OxfordIonTrapGroup/CurrentStabilizer/software/readme.txt

This project was built with:
MPLAB X IDE v3.10
MPLAB XC32 Compiler v1.40 (free version)
PIC32 Legacy Peripheral Libraries (8/6/2015 or 17/6/2015)
