OxfordIonTrapGroup/CurrentStabilizer/current stabiliser.brd

## EAGLE design current stabiliser.brd (2019-03-14)

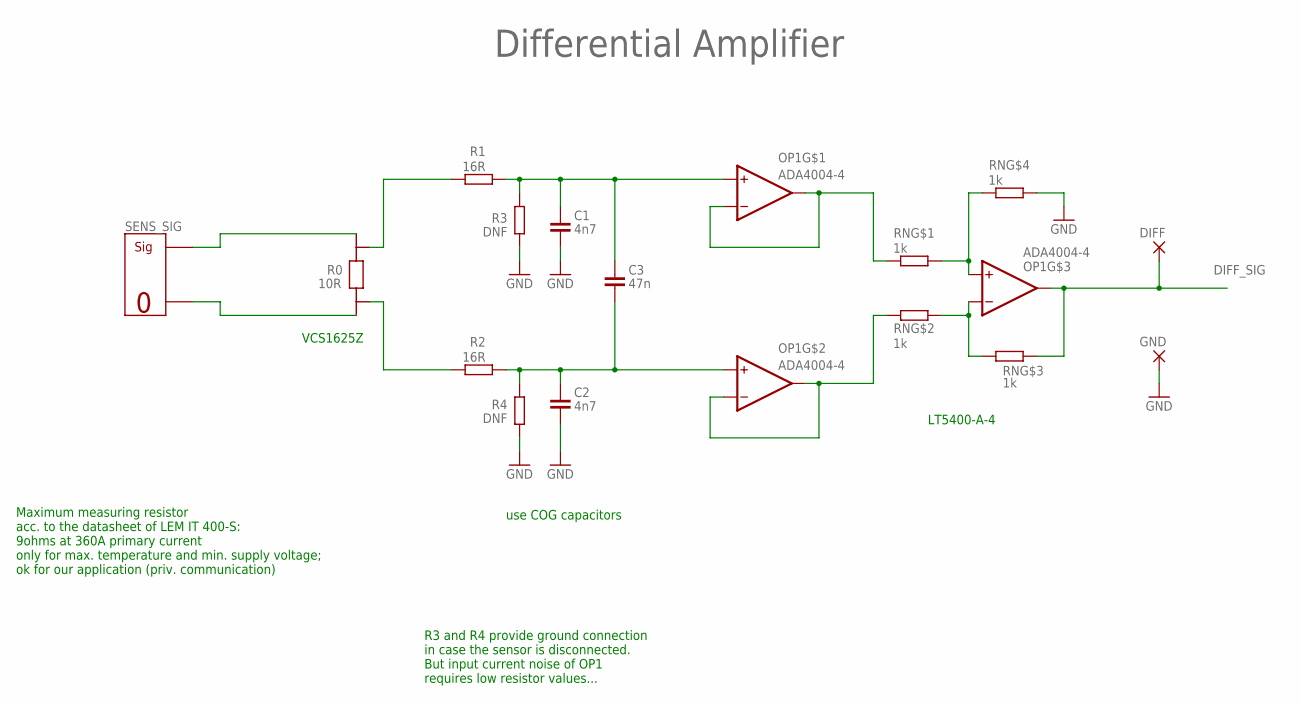
[picture p1: schematic current stabiliser.sch, sheet 1]

Parts:
C1, C2: 4n7; 0603
C3: 47n; 0603
DIFF: TESTPOINT
GND: TESTPOINT
OP1: ADA4004-4; SO14
R0: 10R; VCS1625Z
R1, R2: 16R; 0603
R3, R4: DNF; 0603
RN: 1k; MSOP8-EP
SENS_SIG: MOLEX_SIG_2PIN; MOLEX-2PIN

Connections:
DIFF_SIG: DIFF.P$1, OP1.P$8 (OUT), RN.3 (1); also elsewhere on the board
GND: C1.2, C2.2, GND.P$1, R3.1, R4.1, RN.5 (2); also elsewhere on the board
unnamed: R0.P$1 (I1), SENS_SIG.2 (SIG)
unnamed: C2.1, C3.2, OP1.P$5 (+IN), R2.2, R4.2
unnamed: R0.P$4 (E2), R2.1
unnamed: R0.P$3 (E1), R1.1
unnamed: C1.1, C3.1, OP1.P$3 (+IN), R1.2, R3.2
unnamed: OP1.P$1 (OUT), OP1.P$2 (-IN), RN.1
unnamed: OP1.P$6 (-IN), OP1.P$7 (OUT), RN.2 (1)
unnamed: OP1.P$10 (+IN), RN.4 (1), RN.8 (2)
unnamed: OP1.P$9 (-IN), RN.6 (2), RN.7 (2)
SENS_RETURN: R0.P$2 (I2), SENS_SIG.1 (GND)

Notes on the sheet:
Differential Amplifier
use COG capacitors
R3 and R4 provide ground connection in case the sensor is disconnected. But input current noise of OP1 requires low resistor values...
Maximum measuring resistor acc. to the datasheet of LEM IT 400-S: 9ohms at 360A primary current only for max. temperature and min. supply voltage; ok for our application (priv. communication)
VCS1625Z
LT5400-A-4

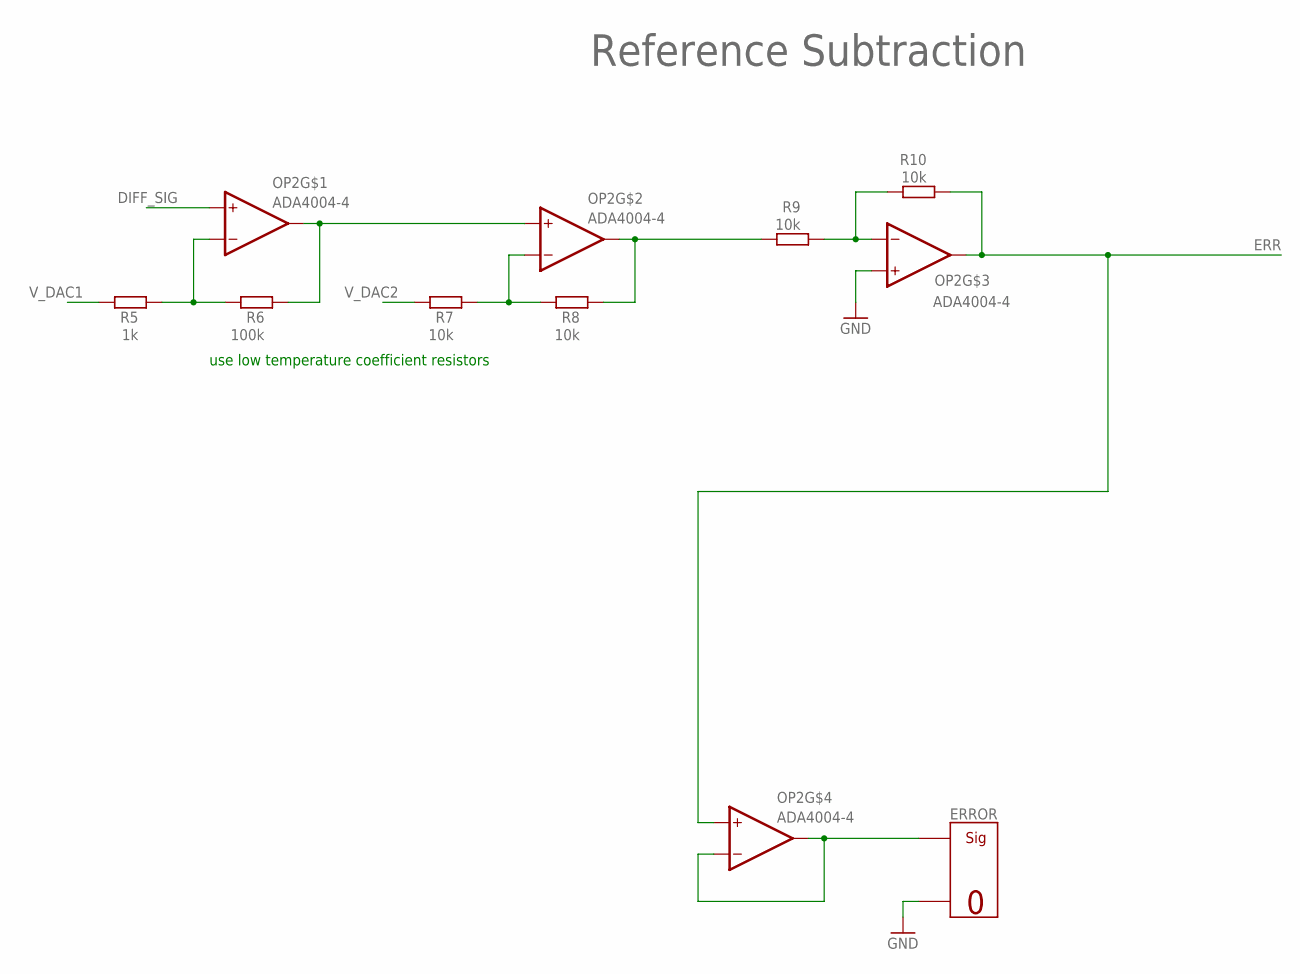
[picture p2: schematic current stabiliser.sch, sheet 2]

Parts:
ERROR: MOLEX_SIG_2PIN; MOLEX-2PIN
OP2: ADA4004-4; SO14
R5: 1k; 0603
R6: 100k; 0603
R7, R8, R9, R10: 10k; 0603

Connections:
DIFF_SIG: OP2.P$3 (+IN); also elsewhere on the board
ERR: OP2.P$8 (OUT), OP2.P$12 (+IN), R10.2; also elsewhere on the board
GND: ERROR.1 (GND), OP2.P$10 (+IN); also elsewhere on the board
unnamed: OP2.P$2 (-IN), R5.2, R6.1
unnamed: OP2.P$9 (-IN), R9.2, R10.1
unnamed: OP2.P$1 (OUT), OP2.P$5 (+IN), R6.2
unnamed: OP2.P$6 (-IN), R7.2, R8.1
unnamed: OP2.P$7 (OUT), R8.2, R9.1
unnamed: ERROR.2 (SIG), OP2.P$13 (-IN), OP2.P$14 (OUT)
V_DAC1: R5.1; also elsewhere on the board
V_DAC2: R7.1; also elsewhere on the board

Notes on the sheet:
Reference Subtraction
use low temperature coefficient resistors

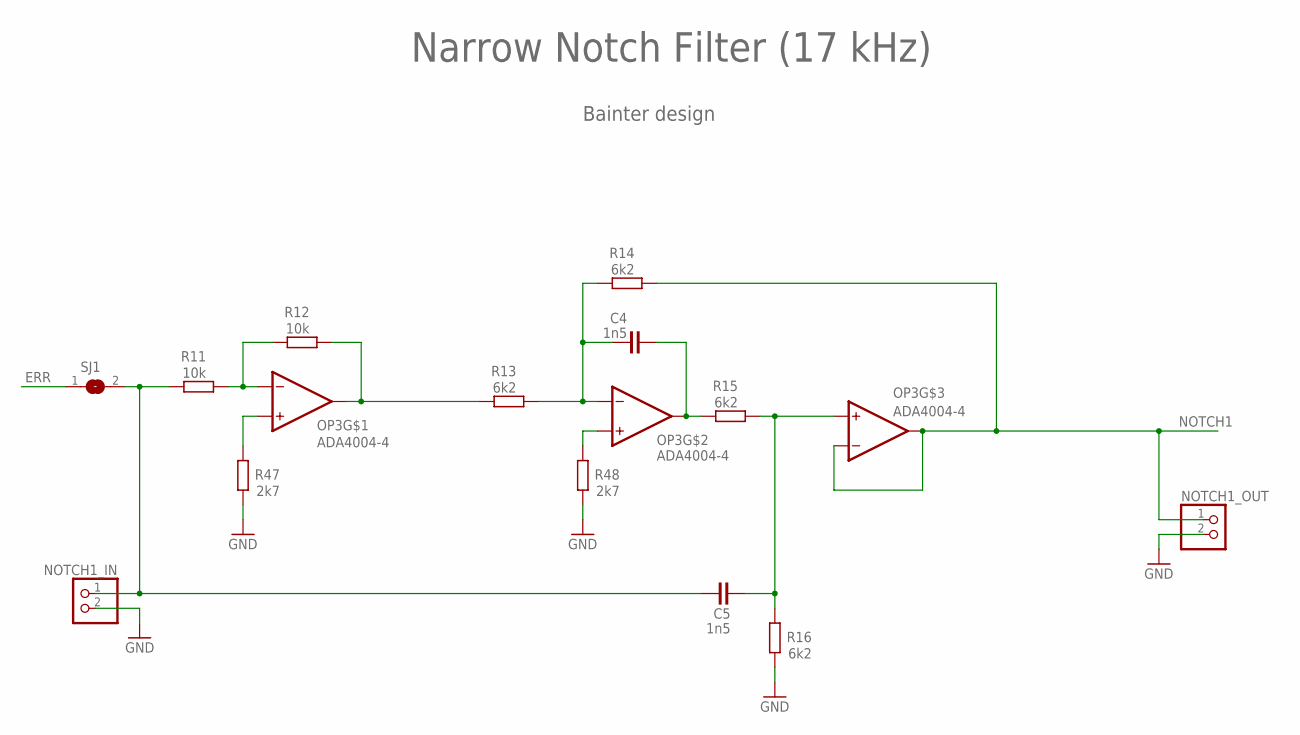
[picture p3: schematic current stabiliser.sch, sheet 3]

Parts:
C4, C5: 1n5; 0603
NOTCH1_IN, NOTCH1_OUT: PINHD-1X2; 1X02
OP3: ADA4004-4; SO14
R11, R12: 10k; 0603
R13, R14, R15, R16: 6k2; 0603
R47, R48: 2k7; 0603
SJ1: SJ

Connections:
ERR: SJ1.1; also elsewhere on the board
GND: NOTCH1_IN.2, NOTCH1_OUT.2, R16.2, R47.2, R48.2; also elsewhere on the board
unnamed: OP3.P$2 (-IN), R11.2, R12.1
unnamed: OP3.P$1 (OUT), R12.2, R13.1
unnamed: C4.1, OP3.P$6 (-IN), R13.2, R14.1
unnamed: C4.2, OP3.P$7 (OUT), R15.1
unnamed: C5.2, OP3.P$10 (+IN), R15.2, R16.1
unnamed: C5.1, NOTCH1_IN.1, R11.1, SJ1.2
unnamed: OP3.P$3 (+IN), R47.1
unnamed: OP3.P$5 (+IN), R48.1
NOTCH1: NOTCH1_OUT.1, OP3.P$8 (OUT), OP3.P$9 (-IN), R14.2; also elsewhere on the board

Notes on the sheet:
Narrow Notch Filter (17 kHz)
Bainter design

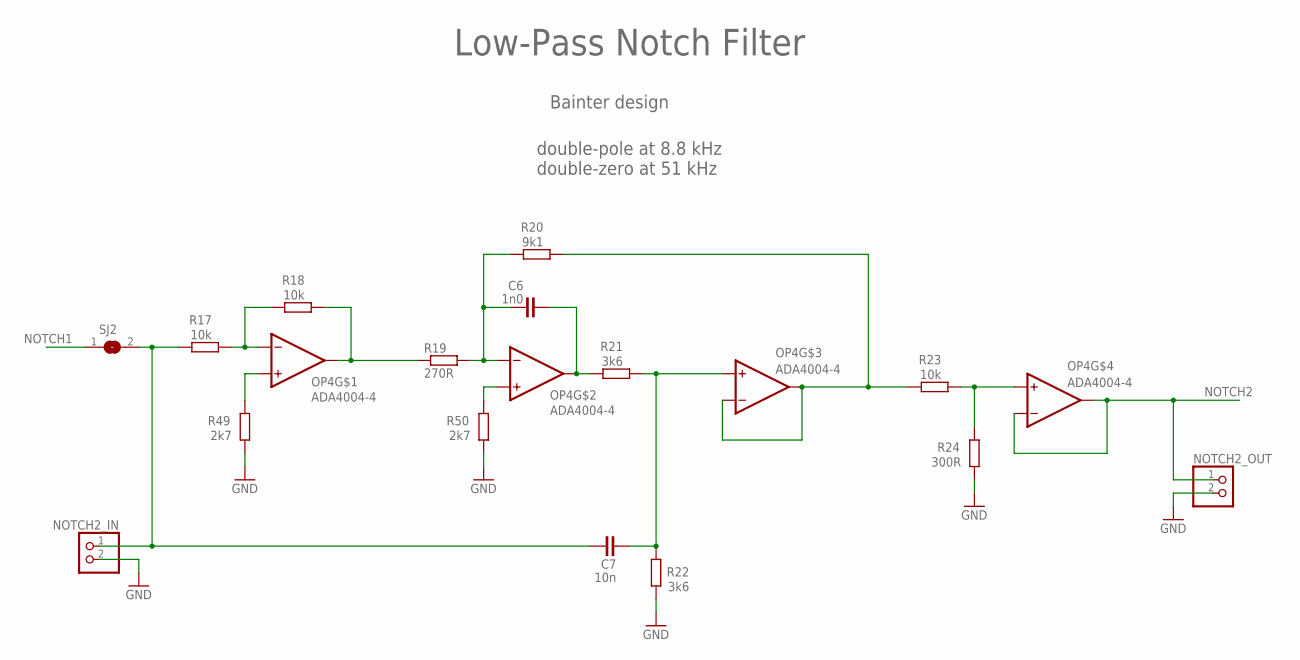
[picture p4: schematic current stabiliser.sch, sheet 4]

Parts:
C6: 1n0; 0603
C7: 10n; 0603
NOTCH2_IN, NOTCH2_OUT: PINHD-1X2; 1X02
OP4: ADA4004-4; SO14
R17, R18, R23: 10k; 0603
R19: 270R; 0603
R20: 9k1; 0603
R21, R22: 3k6; 0603
R24: 300R; 0603
R49, R50: 2k7; 0603
SJ2: SJ

Connections:
GND: NOTCH2_IN.2, NOTCH2_OUT.2, R22.1, R24.1, R49.1, R50.1; also elsewhere on the board
unnamed: OP4.P$2 (-IN), R17.2, R18.1
unnamed: OP4.P$1 (OUT), R18.2, R19.1
unnamed: C6.1, OP4.P$6 (-IN), R19.2, R20.1
unnamed: C7.2, OP4.P$10 (+IN), R21.2, R22.2
unnamed: C6.2, OP4.P$7 (OUT), R21.1
unnamed: OP4.P$8 (OUT), OP4.P$9 (-IN), R20.2, R23.1
unnamed: OP4.P$12 (+IN), R23.2, R24.2
unnamed: C7.1, NOTCH2_IN.1, R17.1, SJ2.2
unnamed: OP4.P$3 (+IN), R49.2
unnamed: OP4.P$5 (+IN), R50.2
NOTCH1: SJ2.1; also elsewhere on the board
NOTCH2: NOTCH2_OUT.1, OP4.P$13 (-IN), OP4.P$14 (OUT); also elsewhere on the board

Notes on the sheet:
Low-Pass Notch Filter
double-pole at 8.8 kHz double-zero at 51 kHz
Bainter design

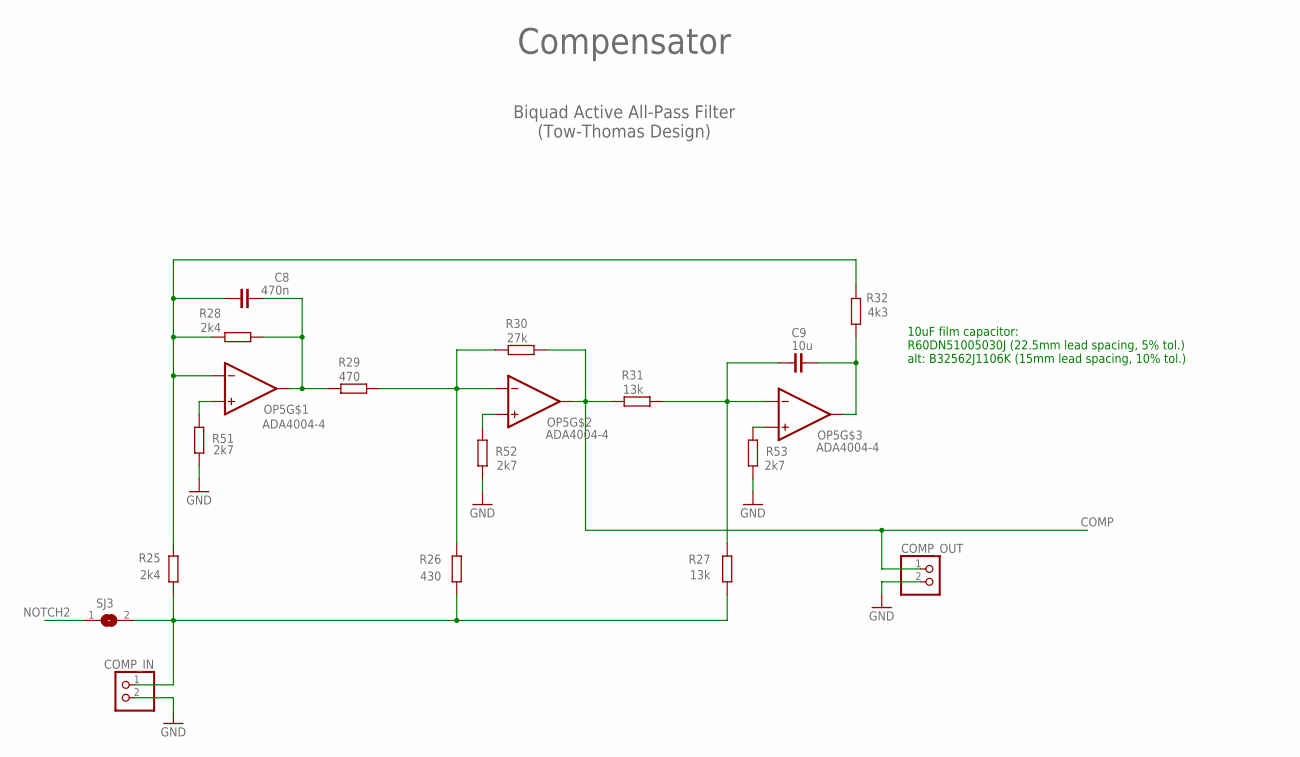
[picture p5: schematic current stabiliser.sch, sheet 5]

Parts:
C8: 470n; 0603
C9: 10u; CAP-26.5X8.5
COMP_IN: PINHD-1X2; 1X02
COMP_OUT: PINHD-1X2; 1X02
OP5: ADA4004-4; SO14
R25, R28: 2k4; 0603
R26: 430; 0603
R27, R31: 13k; 0603
R29: 470; 0603
R30: 27k; 0603
R32: 4k3; 0603
R51, R52, R53: 2k7; 0603
SJ3: SJ

Connections:
COMP: COMP_OUT.1, OP5.P$7 (OUT), R30.2, R31.1; also elsewhere on the board
GND: COMP_IN.2, COMP_OUT.2, R51.1, R52.1, R53.1; also elsewhere on the board
unnamed: C8.1, OP5.P$2 (-IN), R25.2, R28.1, R32.2
unnamed: OP5.P$6 (-IN), R26.2, R29.2, R30.1
unnamed: C9.P$1 (1), OP5.P$9 (-IN), R27.2, R31.2
unnamed: C8.2, OP5.P$1 (OUT), R28.2, R29.1
unnamed: C9.P$2 (2), OP5.P$8 (OUT), R32.1
unnamed: COMP_IN.1, R25.1, R26.1, R27.1, SJ3.2
unnamed: OP5.P$3 (+IN), R51.2
unnamed: OP5.P$5 (+IN), R52.2
unnamed: OP5.P$10 (+IN), R53.2
NOTCH2: SJ3.1; also elsewhere on the board

Notes on the sheet:
10uF film capacitor: R60DN51005030J (22.5mm lead spacing, 5% tol.) alt: B32562J1106K (15mm lead spacing, 10% tol.)
Compensator
Biquad Active All-Pass Filter (Tow-Thomas Design)

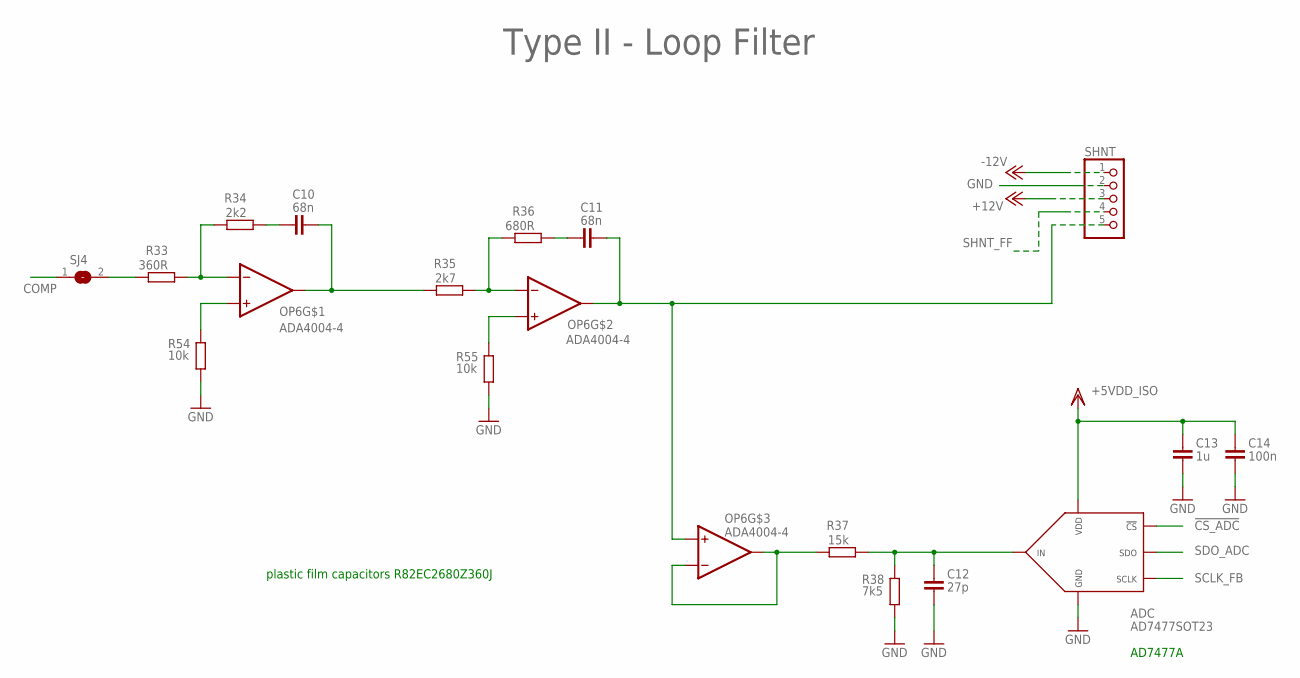
[picture p6: schematic current stabiliser.sch, sheet 6]

Parts:
ADC: AD7477SOT23; SOT23-6
C10, C11: 68n; CAP-R82EC-7.2X2.5
C12: 27p; 0603
C13: 1u; 0805
C14: 100n; 0603
OP6: ADA4004-4; SO14
R33: 360R; 0603
R34: 2k2; 0603
R35: 2k7; 0603
R36: 680R; 0603
R37: 15k; 0603
R38: 7k5; 0603
R54, R55: 10k; 0603
SHNT: MOLEX-KK-1X5; MOLEX-KK-5PIN
SJ4: SJ

Connections:
!CS_ADC: ADC.6 (!CS); also elsewhere on the board
+5VDD_ISO: ADC.1 (VDD), C13.1, C14.1; also elsewhere on the board
+12V: SHNT.3; also elsewhere on the board
-12V: SHNT.1; also elsewhere on the board
COMP: SJ4.1; also elsewhere on the board
GND: ADC.2 (GND), C12.2, C13.2, C14.2, R38.1, R54.1, R55.1, SHNT.2; also elsewhere on the board
unnamed: OP6.P$2 (-IN), R33.2, R34.1
unnamed: OP6.P$3 (+IN), R54.2
unnamed: OP6.P$5 (+IN), R55.2
unnamed: OP6.P$6 (-IN), R35.2, R36.1
unnamed: C11.P$1 (1), R36.2
unnamed: C10.P$1 (1), R34.2
unnamed: C10.P$2 (2), OP6.P$1 (OUT), R35.1
unnamed: OP6.P$8 (OUT), OP6.P$9 (-IN), R37.2
unnamed: ADC.3 (IN), C12.1, R37.1, R38.2
unnamed: R33.1, SJ4.2
SCLK_FB: ADC.4 (SCLK); also elsewhere on the board
SDO_ADC: ADC.5 (SDO); also elsewhere on the board
SHNT_FB: C11.P$2 (2), OP6.P$7 (OUT), OP6.P$10 (+IN), SHNT.5
SHNT_FF: SHNT.4; also elsewhere on the board

Notes on the sheet:
plastic film capacitors R82EC2680Z360J
Type II - Loop Filter
AD7477A

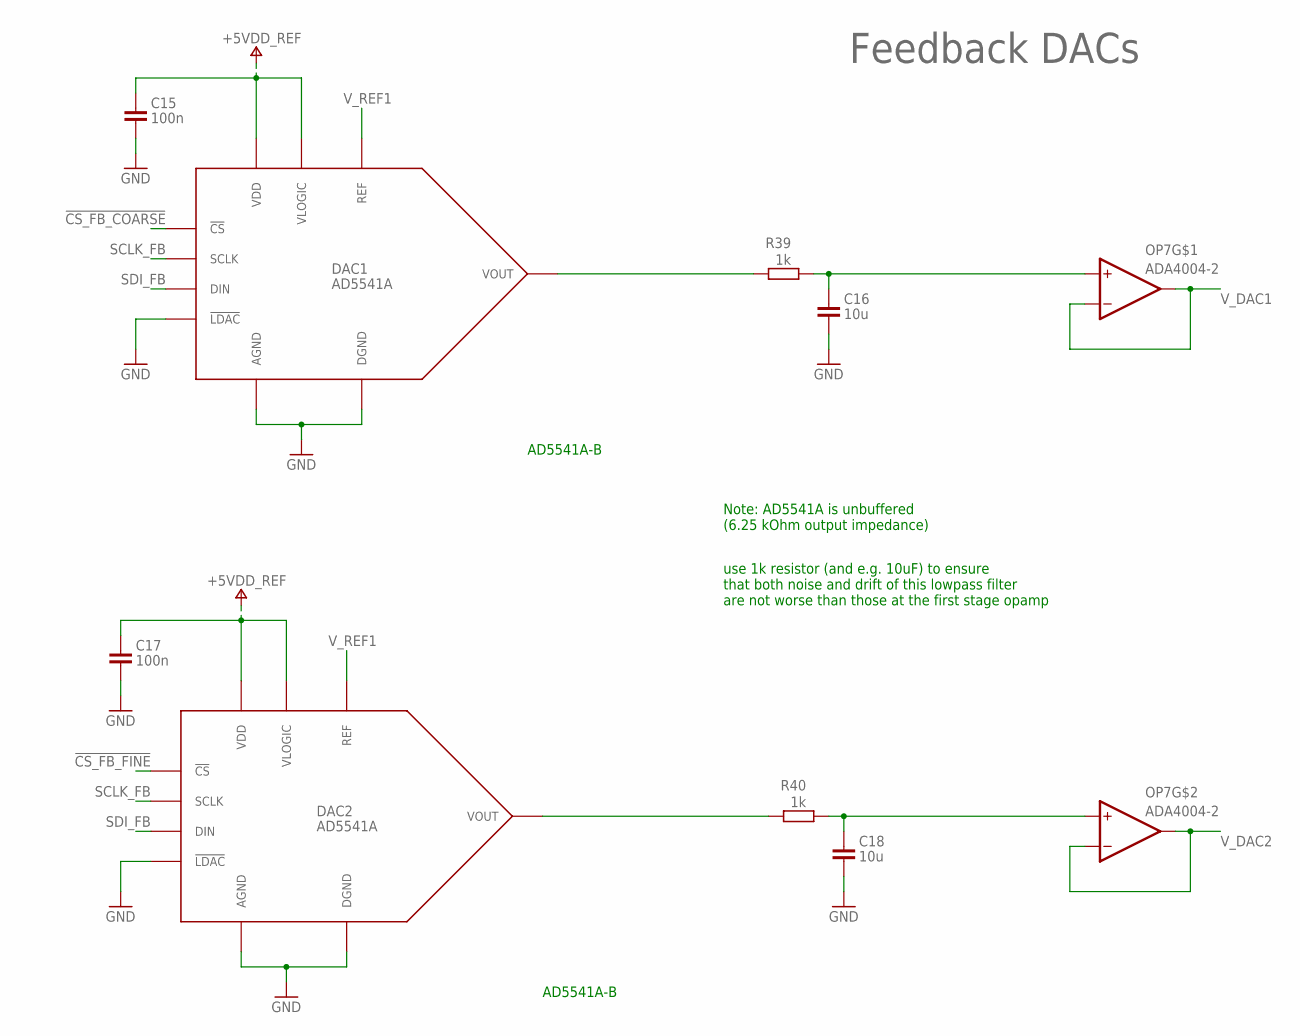
[picture p7: schematic current stabiliser.sch, sheet 7]

Parts:
C15, C17: 100n; 0603
C16, C18: 10u; 0805
DAC1, DAC2: AD5541A; MSOP10_LONG
OP7: ADA4004-2; SO8
R39, R40: 1k; 0603

Connections:
!CS_FB_COARSE: DAC1.5 (!CS); also elsewhere on the board
!CS_FB_FINE: DAC2.5 (!CS); also elsewhere on the board
+5VDD_REF: C15.1, C17.1, DAC1.1 (VDD), DAC1.10 (VLOGIC), DAC2.1 (VDD), DAC2.10 (VLOGIC); also elsewhere on the board
GND: C15.2, C16.2, C17.2, C18.2, DAC1.3 (AGND), DAC1.8 (!LDAC), DAC1.9 (DGND), DAC2.3 (AGND), DAC2.8 (!LDAC), DAC2.9 (DGND); also elsewhere on the board
unnamed: DAC1.2 (VOUT), R39.1
unnamed: C16.1, OP7.3 (+IN), R39.2
unnamed: DAC2.2 (VOUT), R40.1
unnamed: C18.1, OP7.5 (+IN), R40.2
SCLK_FB: DAC1.6 (SCLK), DAC2.6 (SCLK); also elsewhere on the board
SDI_FB: DAC1.7 (DIN), DAC2.7 (DIN); also elsewhere on the board
V_DAC1: OP7.1 (OUT), OP7.2 (-IN); also elsewhere on the board
V_DAC2: OP7.6 (-IN), OP7.7 (OUT); also elsewhere on the board
V_REF1: DAC1.4 (REF), DAC2.4 (REF); also elsewhere on the board

Notes on the sheet:
Feedback DACs
use 1k resistor (and e.g. 10uF) to ensure that both noise and drift of this lowpass filter are not worse than those at the first stage opamp
AD5541A-B
Note: AD5541A is unbuffered (6.25 kOhm output impedance)

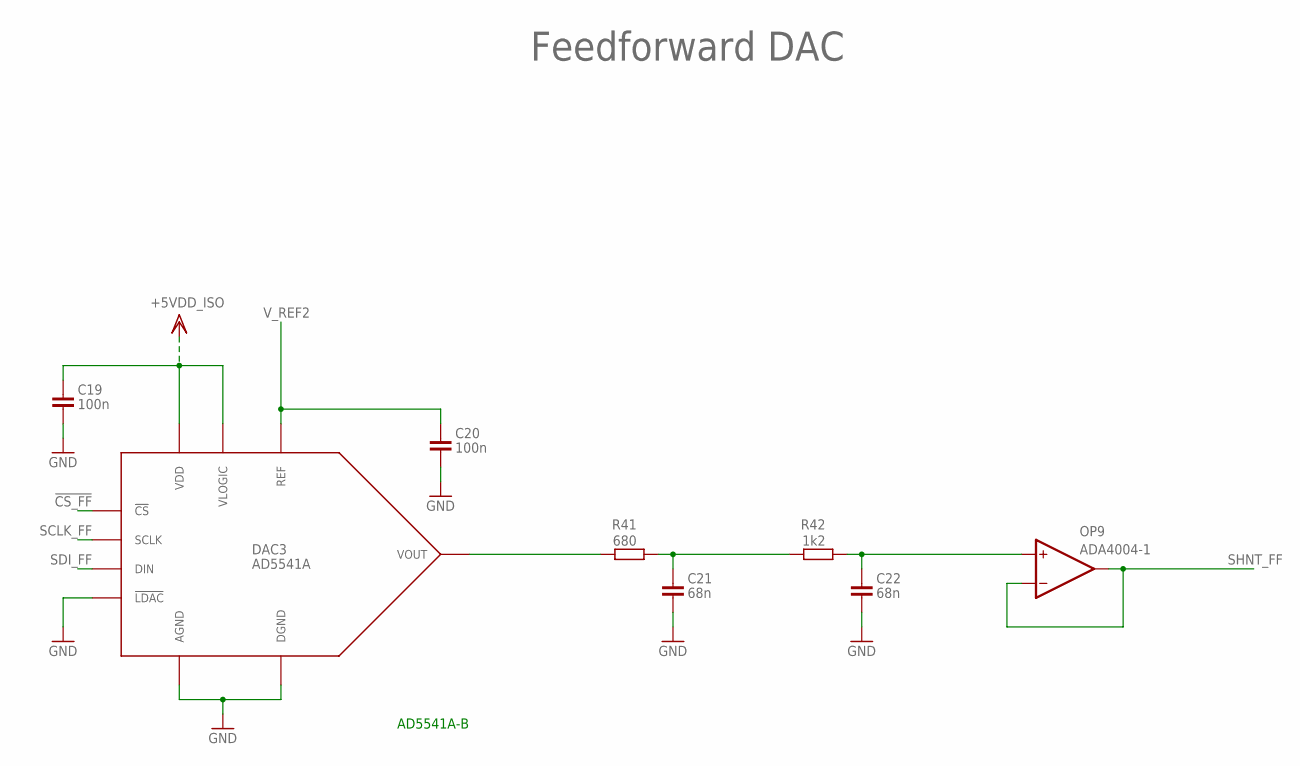
[picture p8: schematic current stabiliser.sch, sheet 8]

Parts:
C19, C20: 100n; 0603
C21, C22: 68n; 0603
DAC3: AD5541A; MSOP10_LONG
OP9: ADA4004-1; SOT23-5
R41: 680; 0603
R42: 1k2; 0603

Connections:
!CS_FF: DAC3.5 (!CS); also elsewhere on the board
+5VDD_ISO: C19.1, DAC3.1 (VDD), DAC3.10 (VLOGIC); also elsewhere on the board
GND: C19.2, C20.2, C21.2, C22.2, DAC3.3 (AGND), DAC3.8 (!LDAC), DAC3.9 (DGND); also elsewhere on the board
unnamed: DAC3.2 (VOUT), R41.1
unnamed: C21.1, R41.2, R42.1
unnamed: C22.1, OP9.3 (+IN), R42.2
SCLK_FF: DAC3.6 (SCLK); also elsewhere on the board
SDI_FF: DAC3.7 (DIN); also elsewhere on the board
SHNT_FF: OP9.1 (OUT), OP9.4 (-IN); also elsewhere on the board
V_REF2: C20.1, DAC3.4 (REF); also elsewhere on the board

Notes on the sheet:
Feedforward DAC
AD5541A-B

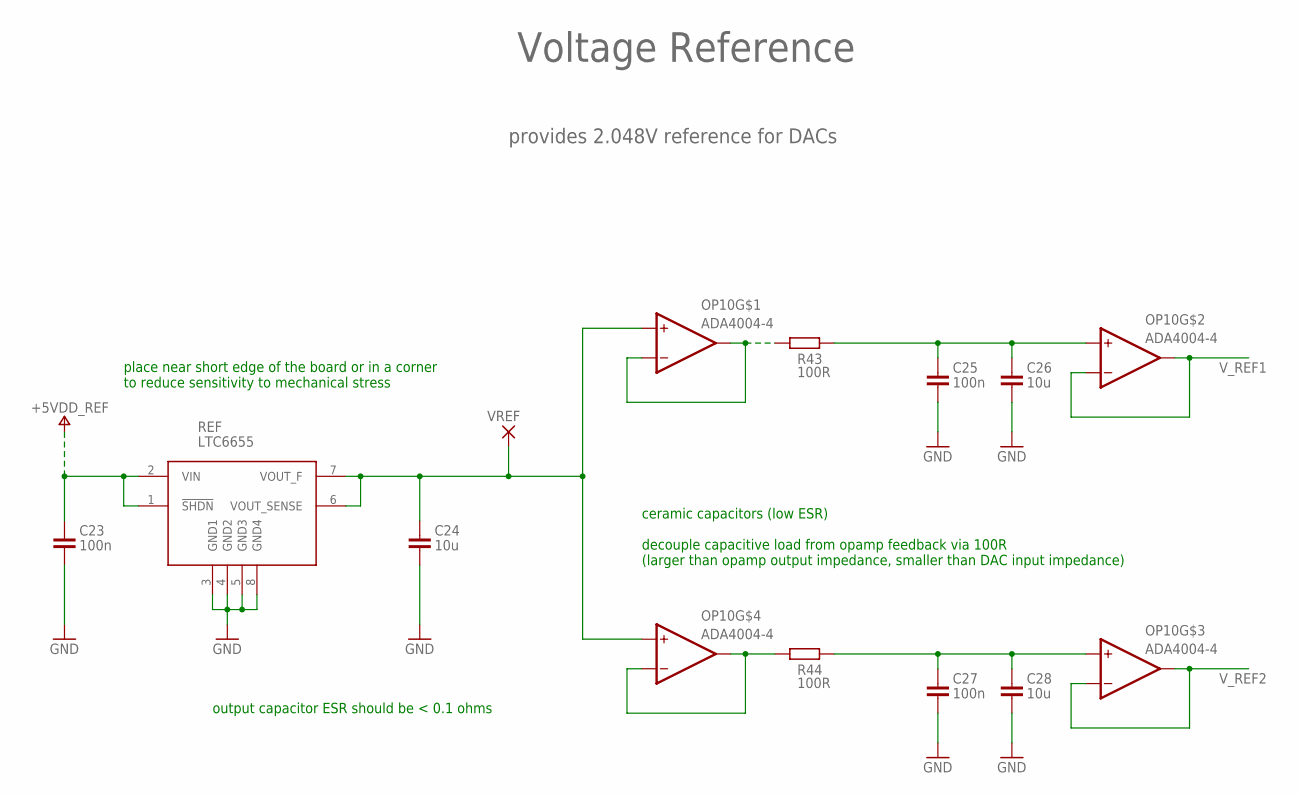
[picture p9: schematic current stabiliser.sch, sheet 9]

Parts:
C23, C25, C27: 100n; 0603
C24, C26, C28: 10u; 0805
OP10: ADA4004-4; SO14
R43, R44: 100R; 0603
REF: LTC6655; MSOP8
VREF: TESTPOINT

Connections:
+5VDD_REF: C23.1, REF.1 (!SHDN), REF.2 (VIN); also elsewhere on the board
GND: C23.2, C24.2, C25.2, C26.2, C27.2, C28.2, REF.3 (GND1), REF.4 (GND2), REF.5 (GND3), REF.8 (GND4); also elsewhere on the board
REF: C24.1, OP10.P$3 (+IN), OP10.P$12 (+IN), REF.6 (VOUT_SENSE), REF.7 (VOUT_F), VREF.P$1
V_REF1: OP10.P$6 (-IN), OP10.P$7 (OUT); also elsewhere on the board
V_REF1A: OP10.P$1 (OUT), OP10.P$2 (-IN), R43.2
V_REF1_LP: C25.1, C26.1, OP10.P$5 (+IN), R43.1
V_REF2: OP10.P$8 (OUT), OP10.P$9 (-IN); also elsewhere on the board
V_REF2_LP: C27.1, C28.1, OP10.P$10 (+IN), R44.1
V_REFBUF1: OP10.P$13 (-IN), OP10.P$14 (OUT), R44.2

Notes on the sheet:
output capacitor ESR should be < 0.1 ohms
Voltage Reference
provides 2.048V reference for DACs
ceramic capacitors (low ESR) decouple capacitive load from opamp feedback via 100R (larger than opamp output impedance, smaller than DAC input impedance)
place near short edge of the board or in a corner to reduce sensitivity to mechanical stress

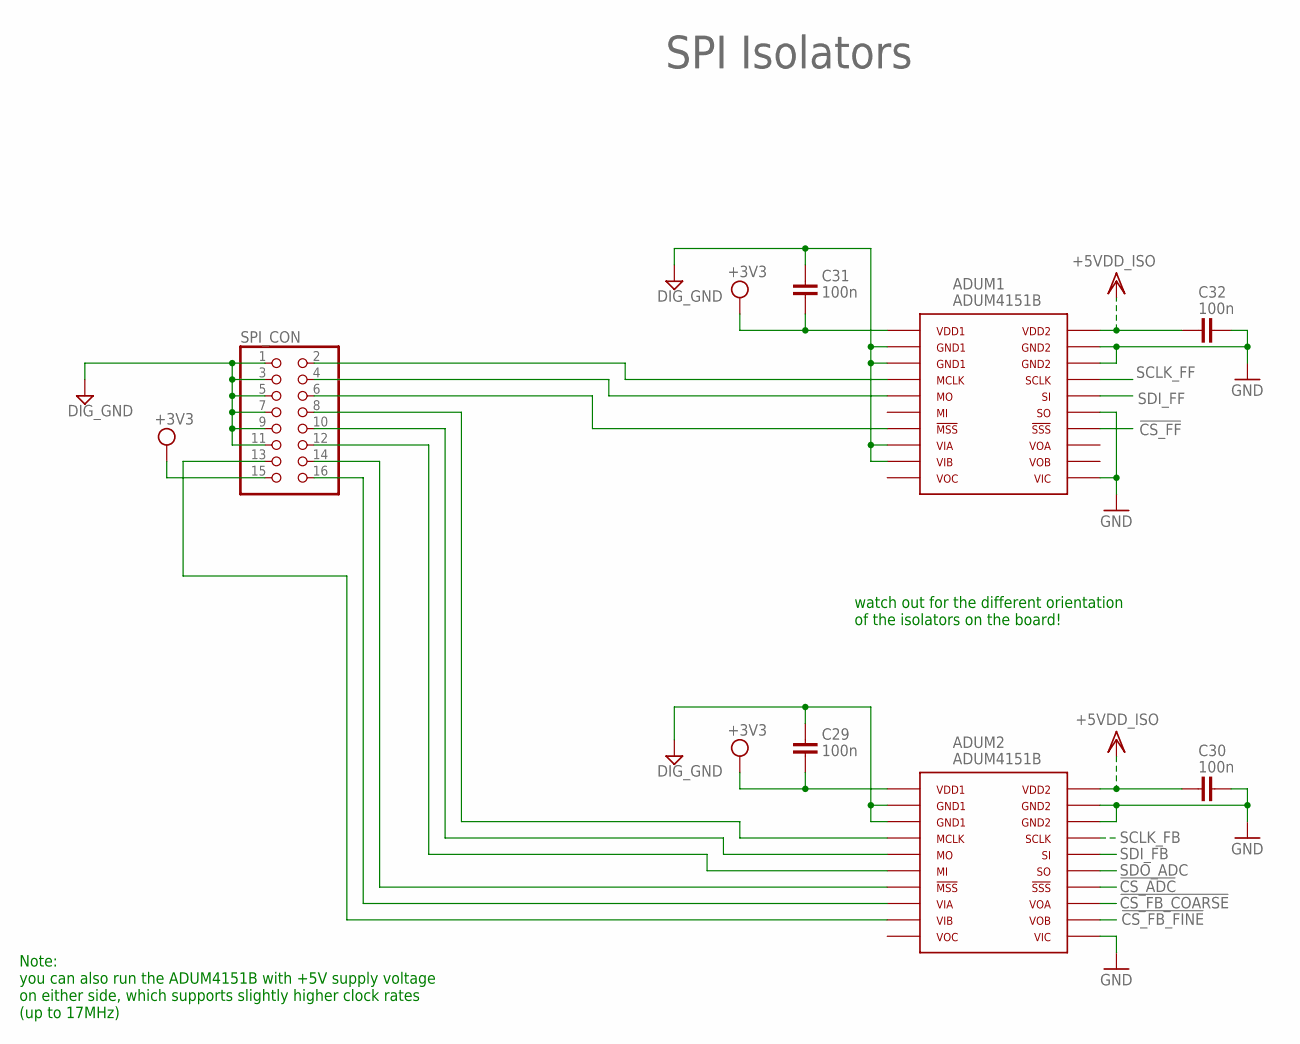
[picture p10: schematic current stabiliser.sch, sheet 10]

Parts:
ADUM1, ADUM2: ADUM4151B; SOIC_IC-20
C29, C30, C31, C32: 100n; 0603
SPI_CON: SPI_FB; HEADER-2X8-BOX

Connections:
!CS_ADC: ADUM2.15 (!SSS); also elsewhere on the board
!CS_FB_COARSE: ADUM2.14 (VOA); also elsewhere on the board
!CS_FB_FINE: ADUM2.13 (VOB); also elsewhere on the board
!CS_FF: ADUM1.15 (!SSS); also elsewhere on the board
+3V3DIG: ADUM1.1 (VDD1), ADUM2.1 (VDD1), C29.2, C31.2, SPI_CON.15
+5VDD_ISO: ADUM1.20 (VDD2), ADUM2.20 (VDD2), C30.1, C32.1; also elsewhere on the board
DGND: ADUM1.2 (GND1), ADUM1.7 (VIA), ADUM1.8 (VIB), ADUM1.10 (GND1), ADUM2.2 (GND1), ADUM2.10 (GND1), C29.1, C31.1, SPI_CON.1, SPI_CON.3, SPI_CON.5, SPI_CON.7, SPI_CON.9, SPI_CON.11
DIG_FF_CLK: ADUM1.3 (MCLK), SPI_CON.2
DIG_FF_CS: ADUM1.6 (!MSS), SPI_CON.6
DIG_FF_SIG: ADUM1.4 (MO), SPI_CON.4
GND: ADUM1.11 (GND2), ADUM1.12 (VIC), ADUM1.16 (SO), ADUM1.19 (GND2), ADUM2.11 (GND2), ADUM2.12 (VIC), ADUM2.19 (GND2), C30.2, C32.2; also elsewhere on the board
unnamed: ADUM2.4 (MO), SPI_CON.10
unnamed: ADUM2.5 (MI), SPI_CON.12
unnamed: ADUM2.6 (!MSS), SPI_CON.14
unnamed: ADUM2.7 (VIA), SPI_CON.16
unnamed: ADUM2.8 (VIB), SPI_CON.13
unnamed: ADUM2.3 (MCLK), SPI_CON.8
SCLK_FB: ADUM2.18 (SCLK); also elsewhere on the board
SCLK_FF: ADUM1.18 (SCLK); also elsewhere on the board
SDI_FB: ADUM2.17 (SI); also elsewhere on the board
SDI_FF: ADUM1.17 (SI); also elsewhere on the board
SDO_ADC: ADUM2.16 (SO); also elsewhere on the board

Notes on the sheet:
SPI Isolators
watch out for the different orientation of the isolators on the board!
Note: you can also run the ADUM4151B with +5V supply voltage on either side, which supports slightly higher clock rates (up to 17MHz)

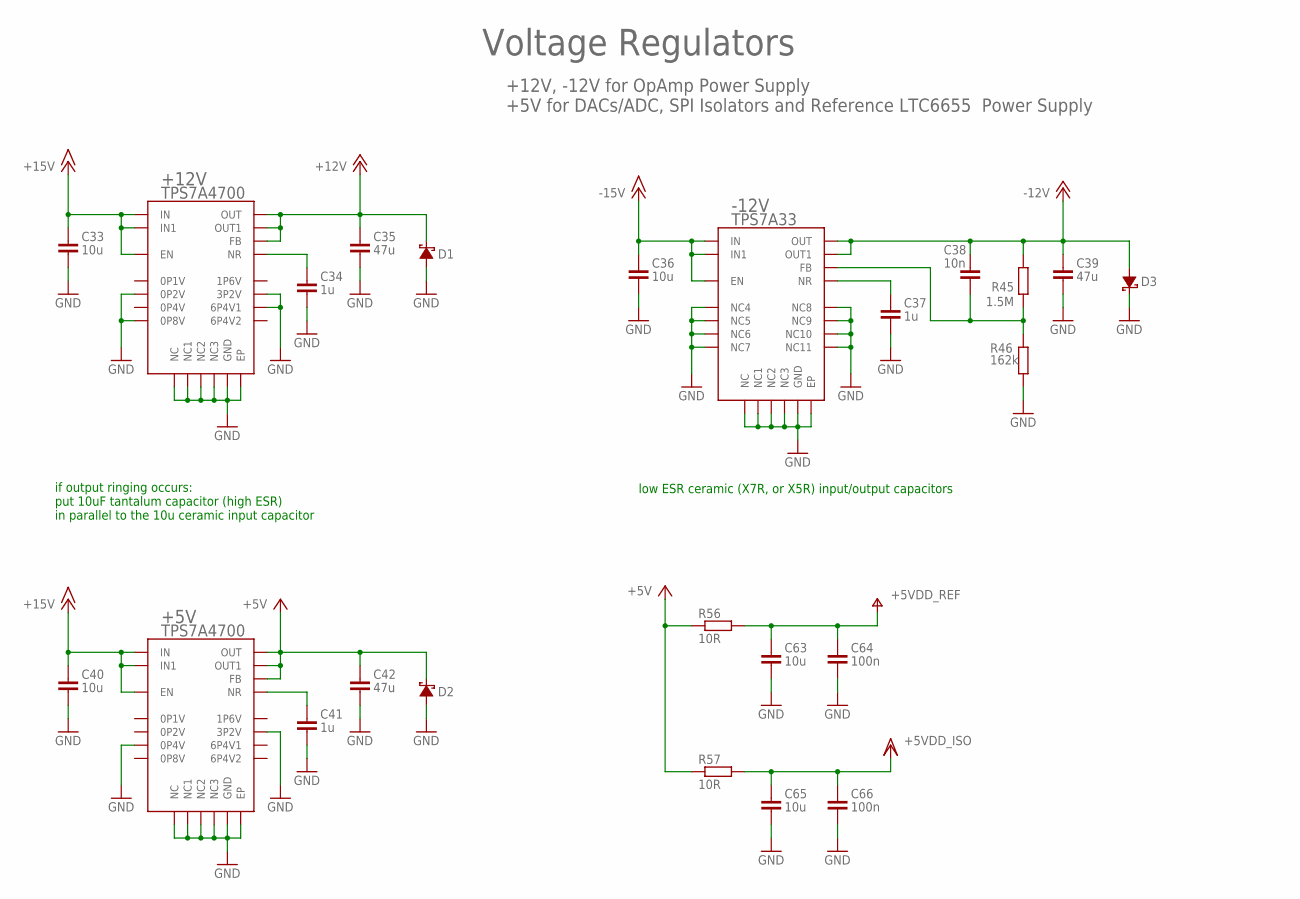
[picture p11: schematic current stabiliser.sch, sheet 11]

Parts:
+5V, +12V: TPS7A4700; QFN20_5
-12V: TPS7A33; QFN20_5
C33, C36, C40, C63, C65: 10u; 0805
C34, C37, C41: 1u; 0805
C35, C39, C42: 47u; 1206
C38: 10n; 0805
C64, C66: 100n; 0603
D1, D2, D3: DIODE_SCHOTTKY; SOD523
R45: 1.5M; 0603
R46: 162k; 0603
R56, R57: 10R; 0603

Connections:
+5V: +5V.P$1 (OUT), +5V.P$3 (FB), +5V.P$20 (OUT1), C42.1, D2.K, R56.1, R57.1
+5VDD_ISO: C65.1, C66.1, R57.2; also elsewhere on the board
+5VDD_REF: C63.1, C64.1, R56.2; also elsewhere on the board
+12V: +12V.P$1 (OUT), +12V.P$3 (FB), +12V.P$20 (OUT1), C35.1, D1.K; also elsewhere on the board
+15V: +5V.P$13 (EN), +5V.P$15 (IN), +5V.P$16 (IN1), +12V.P$13 (EN), +12V.P$15 (IN), +12V.P$16 (IN1), C33.1, C40.1; also elsewhere on the board
-12V: -12V.P$1 (OUT), -12V.P$20 (OUT1), C38.1, C39.1, D3.A, R45.2; also elsewhere on the board
-15V: -12V.P$13 (EN), -12V.P$15 (IN), -12V.P$16 (IN1), C36.1; also elsewhere on the board
GND: +5V.EP, +5V.P$2 (NC), +5V.P$6 (3P2V), +5V.P$7 (GND), +5V.P$10 (0P4V), +5V.P$17 (NC1), +5V.P$18 (NC2), +5V.P$19 (NC3), +12V.EP, +12V.P$2 (NC), +12V.P$4 (6P4V1), +12V.P$6 (3P2V), +12V.P$7 (GND), +12V.P$9 (0P8V), +12V.P$11 (0P2V), +12V.P$17 (NC1), +12V.P$18 (NC2), +12V.P$19 (NC3), -12V.EP, -12V.P$2 (NC), -12V.P$4 (NC1), -12V.P$5 (NC2), -12V.P$6 (NC3), -12V.P$7 (GND), -12V.P$8 (NC4), -12V.P$9 (NC5), -12V.P$10 (NC6), -12V.P$11 (NC7), -12V.P$12 (NC8), -12V.P$17 (NC9), -12V.P$18 (NC10), -12V.P$19 (NC11), C33.2, C34.2, C35.2, C36.2, C37.2, C39.2, C40.2, C41.2, C42.2, C63.2, C64.2, C65.2, C66.2, D1.A, D2.A, D3.K, R46.1; also elsewhere on the board
unnamed: +5V.P$14 (NR), C41.1
unnamed: +12V.P$14 (NR), C34.1
unnamed: -12V.P$3 (FB), C38.2, R45.1, R46.2
unnamed: -12V.P$14 (NR), C37.1

Notes on the sheet:
Voltage Regulators
+12V, -12V for OpAmp Power Supply +5V for DACs/ADC, SPI Isolators and Reference LTC6655 Power Supply
low ESR ceramic (X7R, or X5R) input/output capacitors
if output ringing occurs: put 10uF tantalum capacitor (high ESR) in parallel to the 10u ceramic input capacitor

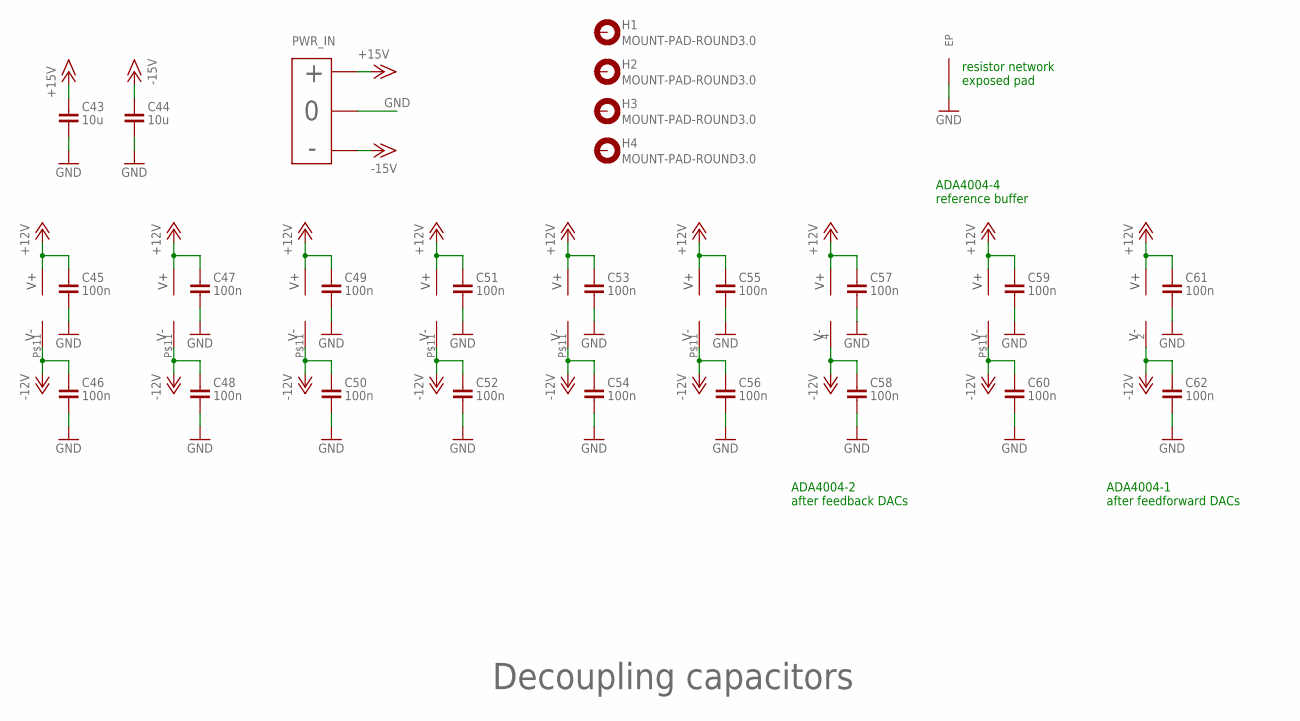
[picture p12: schematic current stabiliser.sch, sheet 12]

Parts:
C43, C44: 10u; 0805
C45, C46, C47, C48, C49, C50, C51, C52, C53, C54, C55, C56, C57, C58, C59, C60, C61, C62: 100n; 0603
H1, H2, H3, H4: MOUNT-PAD-ROUND3.0; 3,0-PAD
OP1, OP2, OP3, OP4, OP5, OP6, OP10: ADA4004-4; SO14
OP7: ADA4004-2; SO8
OP9: ADA4004-1; SOT23-5
PWR_IN: MOLEX_POWER_3PINKK; MOLEX-3PIN
RN: 1k; MSOP8-EP

Connections:
+12V: C45.1, C47.1, C49.1, C51.1, C53.1, C55.1, C57.1, C59.1, C61.1, OP1.P$4 (V+), OP2.P$4 (V+), OP3.P$4 (V+), OP4.P$4 (V+), OP5.P$4 (V+), OP6.P$4 (V+), OP7.8 (V+), OP9.5 (V+), OP10.P$4 (V+); also elsewhere on the board
+15V: C43.1, PWR_IN.3 (+); also elsewhere on the board
-12V: C46.1, C48.1, C50.1, C52.1, C54.1, C56.1, C58.1, C60.1, C62.1, OP1.P$11 (V-), OP2.P$11 (V-), OP3.P$11 (V-), OP4.P$11 (V-), OP5.P$11 (V-), OP6.P$11 (V-), OP7.4 (V-), OP9.2 (V-), OP10.P$11 (V-); also elsewhere on the board
-15V: C44.1, PWR_IN.1 (-); also elsewhere on the board
GND: C43.2, C44.2, C45.2, C46.2, C47.2, C48.2, C49.2, C50.2, C51.2, C52.2, C53.2, C54.2, C55.2, C56.2, C57.2, C58.2, C59.2, C60.2, C61.2, C62.2, PWR_IN.2 (0), RN.EP; also elsewhere on the board

Notes on the sheet:
Decoupling capacitors
ADA4004-2 after feedback DACs
ADA4004-1 after feedforward DACs
resistor network exposed pad
ADA4004-4 reference buffer

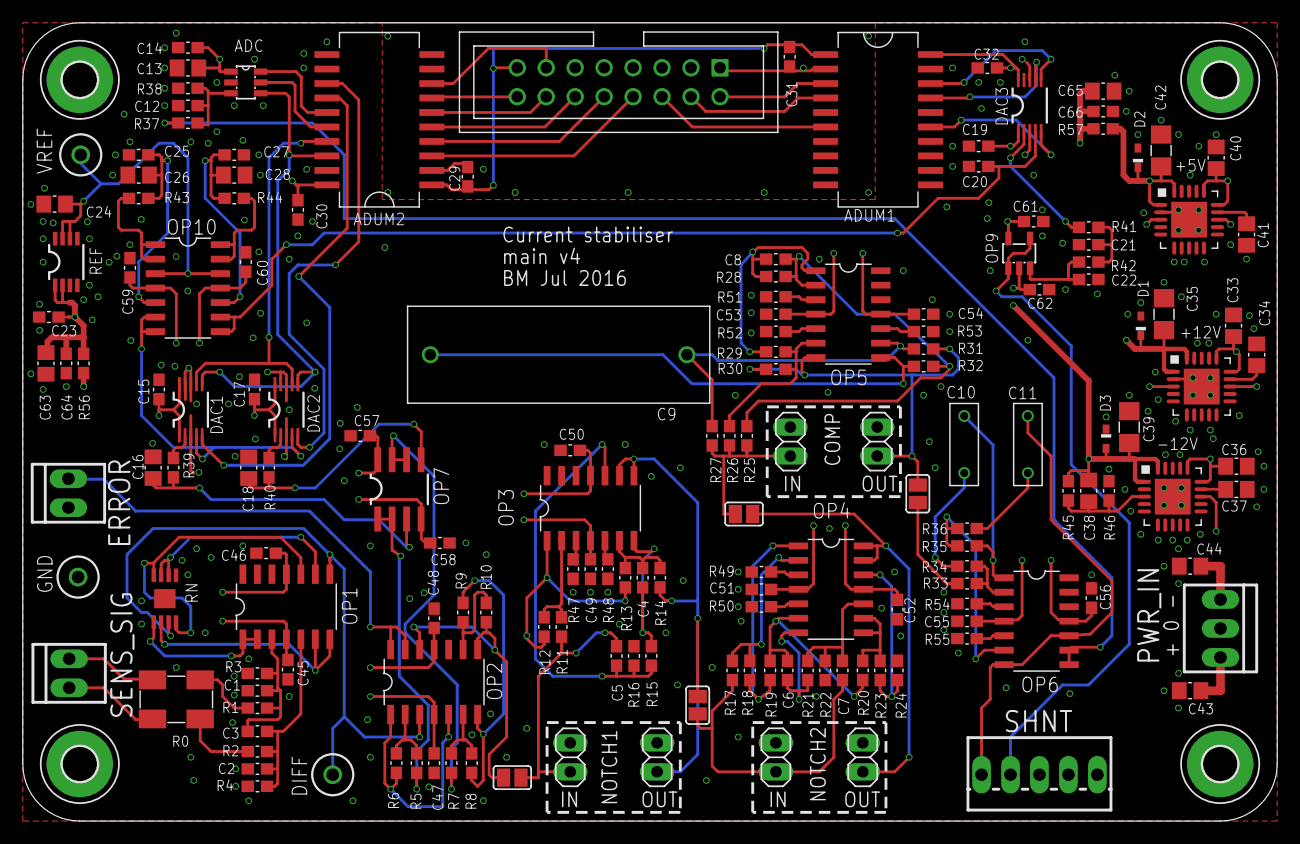
[picture p13: board current stabiliser.brd from above]

Board: 4 copper layers, 110.0 x 70.0 mm, 169 parts (0 on the bottom side), 108 nets.
