OxfordIonTrapGroup/CurrentStabilizer/current shunt.brd

## EAGLE design current shunt.brd (2019-03-14)

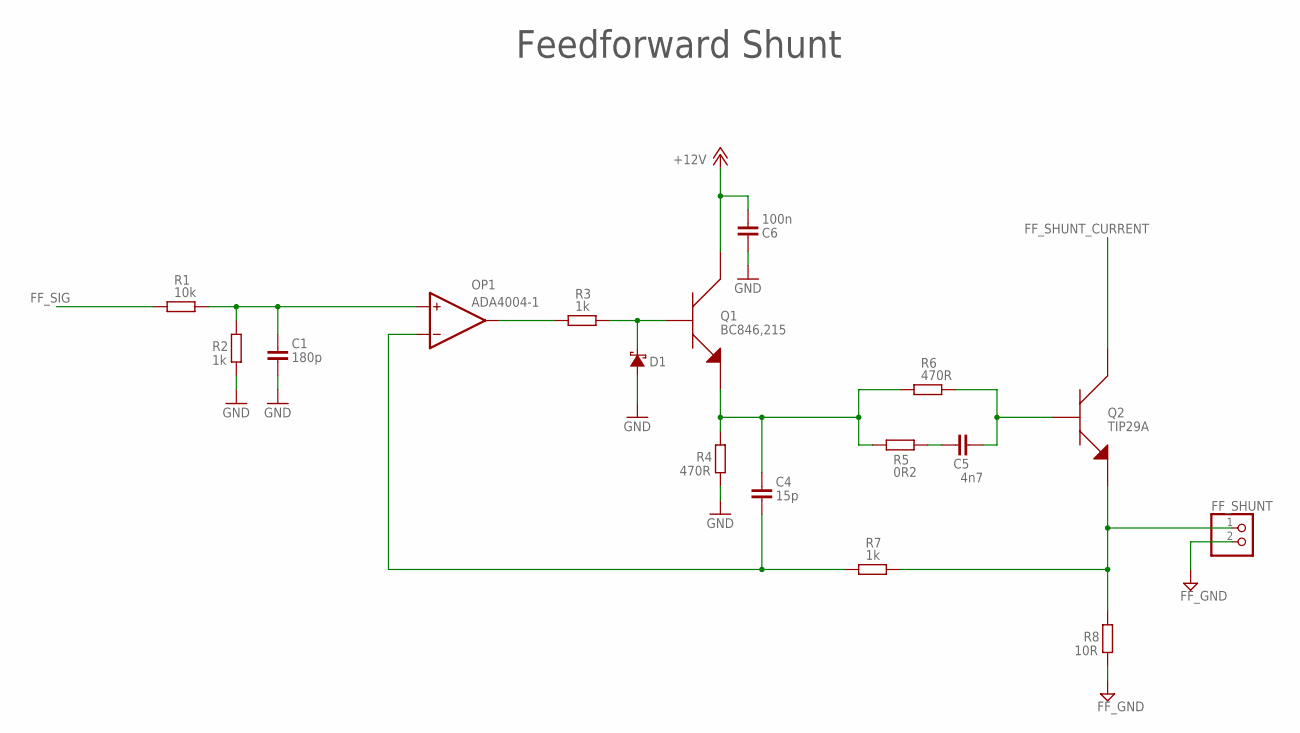
[picture p14: schematic current shunt.sch, sheet 1]

Parts:
C1: 180p; 0603
C4: 15p; 0603
C5: 4n7; 0603
C6: 100n; 0603
D1: DIODE_SCHOTTKY; SOD123F
FF_SHUNT: PINHD-1X2; 1X02
OP1: ADA4004-1; SOT23-5
Q1: BC846,215; SOT23
Q2: TIP29A; TO-220_DETATCHED
R1: 10k; 0603
R2, R3, R7: 1k; 0603
R4, R6: 470R; 0603
R5: 0R2; 0603
R8: 10R; 0603

Connections:
+12V: C6.1, Q1.3 (COLLECTOR); also elsewhere on the board
FB_SHUNT: FF_SHUNT.1, Q2.EMITTER, R7.2, R8.2
FF_GND: FF_SHUNT.2, R8.1; also elsewhere on the board
FF_SHUNT_CURRENT: Q2.COLLECTOR; also elsewhere on the board
FF_SIG: R1.1; also elsewhere on the board
GND: C1.2, C6.2, D1.P$2 (A), R2.1, R4.1; also elsewhere on the board
unnamed: C4.2, OP1.4 (-IN), R7.1
unnamed: C1.1, OP1.3 (+IN), R1.2, R2.2
unnamed: C5.1, R5.2
unnamed: OP1.1 (OUT), R3.1
unnamed: D1.P$1 (K), Q1.1 (BASE), R3.2
unnamed: C4.1, Q1.2 (EMITTER), R4.2, R5.1, R6.1
unnamed: C5.2, Q2.BASE, R6.2

Notes on the sheet:
Feedforward Shunt

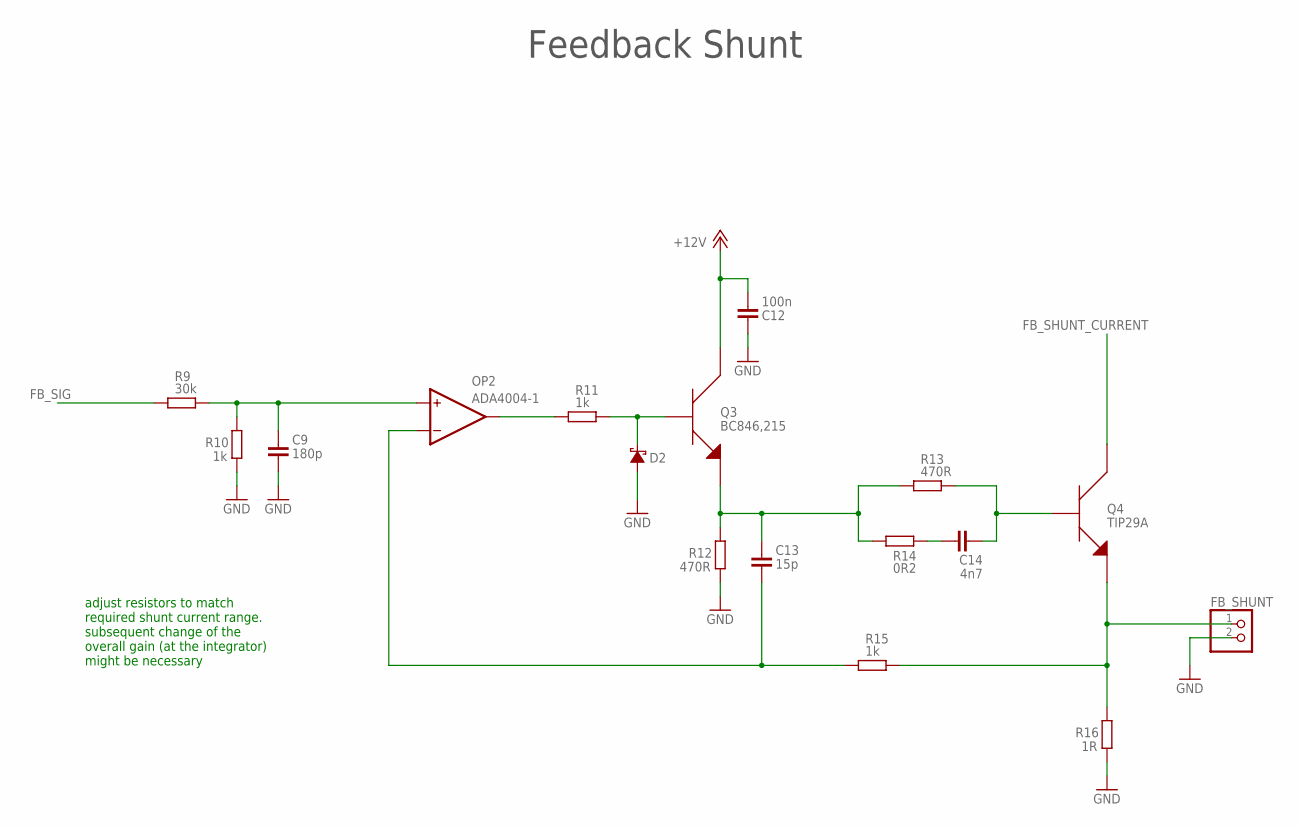
[picture p15: schematic current shunt.sch, sheet 2]

Parts:
C9: 180p; 0603
C12: 100n; 0603
C13: 15p; 0603
C14: 4n7; 0603
D2: DIODE_SCHOTTKY; SOD123F
FB_SHUNT: PINHD-1X2; 1X02
OP2: ADA4004-1; SOT23-5
Q3: BC846,215; SOT23
Q4: TIP29A; TO-220_DETATCHED
R9: 30k; 0603
R10, R11, R15: 1k; 0603
R12, R13: 470R; 0603
R14: 0R2; 0603
R16: 1R; 0603

Connections:
+12V: C12.1, Q3.3 (COLLECTOR); also elsewhere on the board
FB_SHUNT_CURRENT: Q4.COLLECTOR; also elsewhere on the board
FB_SIG: R9.1; also elsewhere on the board
FF_SHUNT: FB_SHUNT.1, Q4.EMITTER, R15.2, R16.2
GND: C9.2, C12.2, D2.P$2 (A), FB_SHUNT.2, R10.1, R12.1, R16.1; also elsewhere on the board
unnamed: C13.2, OP2.4 (-IN), R15.1
unnamed: C9.1, OP2.3 (+IN), R9.2, R10.2
unnamed: OP2.1 (OUT), R11.1
unnamed: D2.P$1 (K), Q3.1 (BASE), R11.2
unnamed: C13.1, Q3.2 (EMITTER), R12.2, R13.1, R14.1
unnamed: C14.2, Q4.BASE, R13.2
unnamed: C14.1, R14.2

Notes on the sheet:
Feedback Shunt
adjust resistors to match required shunt current range. subsequent change of the overall gain (at the integrator) might be necessary

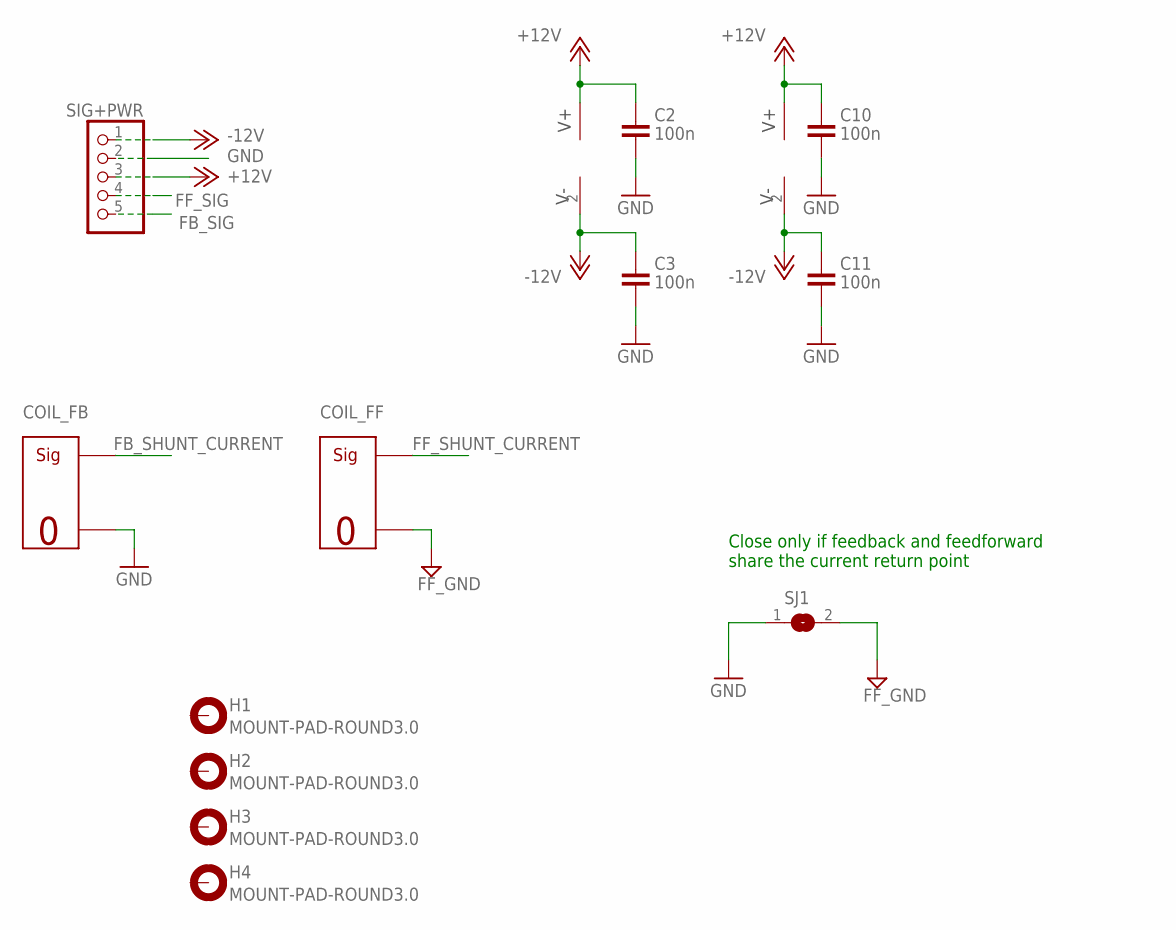
[picture p16: schematic current shunt.sch, sheet 3]

Parts:
C2, C3, C10, C11: 100n; 0603
COIL_FB: MOLEX_SIG_2PIN; MOLEX-2PIN
COIL_FF: MOLEX_SIG_2PIN; MOLEX-2PIN
H1, H2, H3, H4: MOUNT-PAD-ROUND3.0; 3,0-PAD
OP1, OP2: ADA4004-1; SOT23-5
SIG+PWR: MOLEX-KK-1X5; MOLEX-KK-5PIN
SJ1: SJ

Connections:
+12V: C2.1, C10.1, OP1.5 (V+), OP2.5 (V+), SIG+PWR.3; also elsewhere on the board
-12V: C3.1, C11.1, OP1.2 (V-), OP2.2 (V-), SIG+PWR.1
FB_SHUNT_CURRENT: COIL_FB.2 (SIG); also elsewhere on the board
FB_SIG: SIG+PWR.5; also elsewhere on the board
FF_GND: COIL_FF.1 (GND), SJ1.2; also elsewhere on the board
FF_SHUNT_CURRENT: COIL_FF.2 (SIG); also elsewhere on the board
FF_SIG: SIG+PWR.4; also elsewhere on the board
GND: C2.2, C3.2, C10.2, C11.2, COIL_FB.1 (GND), SIG+PWR.2, SJ1.1; also elsewhere on the board

Notes on the sheet:
Close only if feedback and feedforward share the current return point

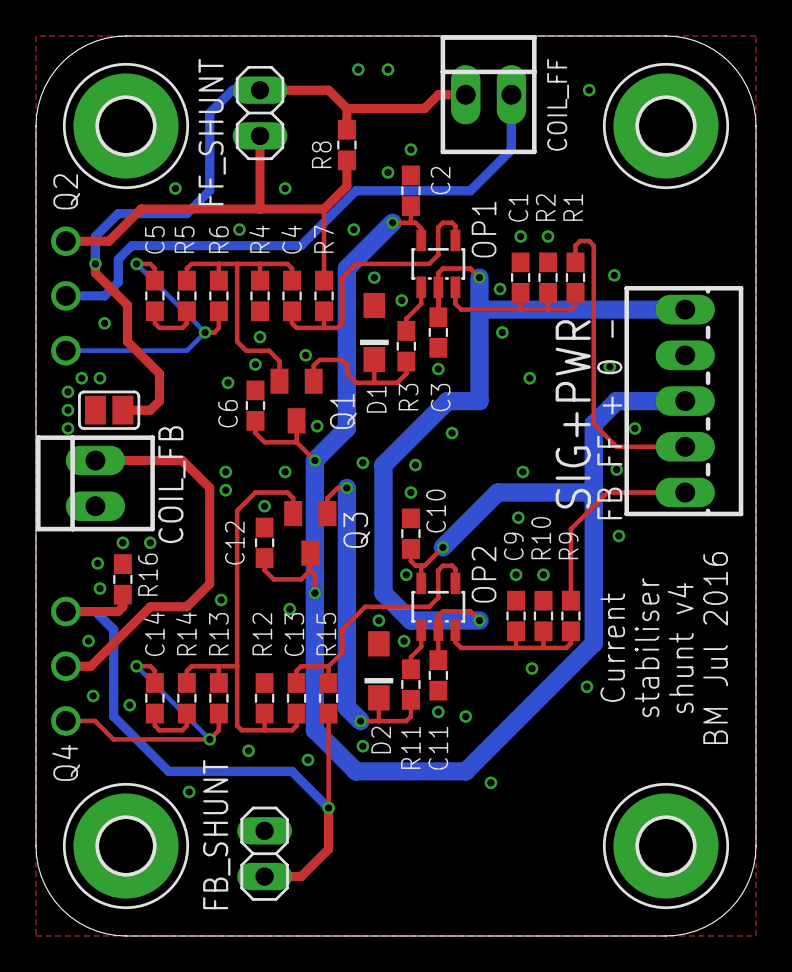
[picture p17: board current shunt.brd from above]

Board: 2 copper layers, 40.0 x 50.0 mm, 46 parts (0 on the bottom side), 24 nets.
