OxfordIonTrapGroup/CurrentStabilizer/beaglebone black cape.brd

## EAGLE design beaglebone black cape.brd (2018-09-12)

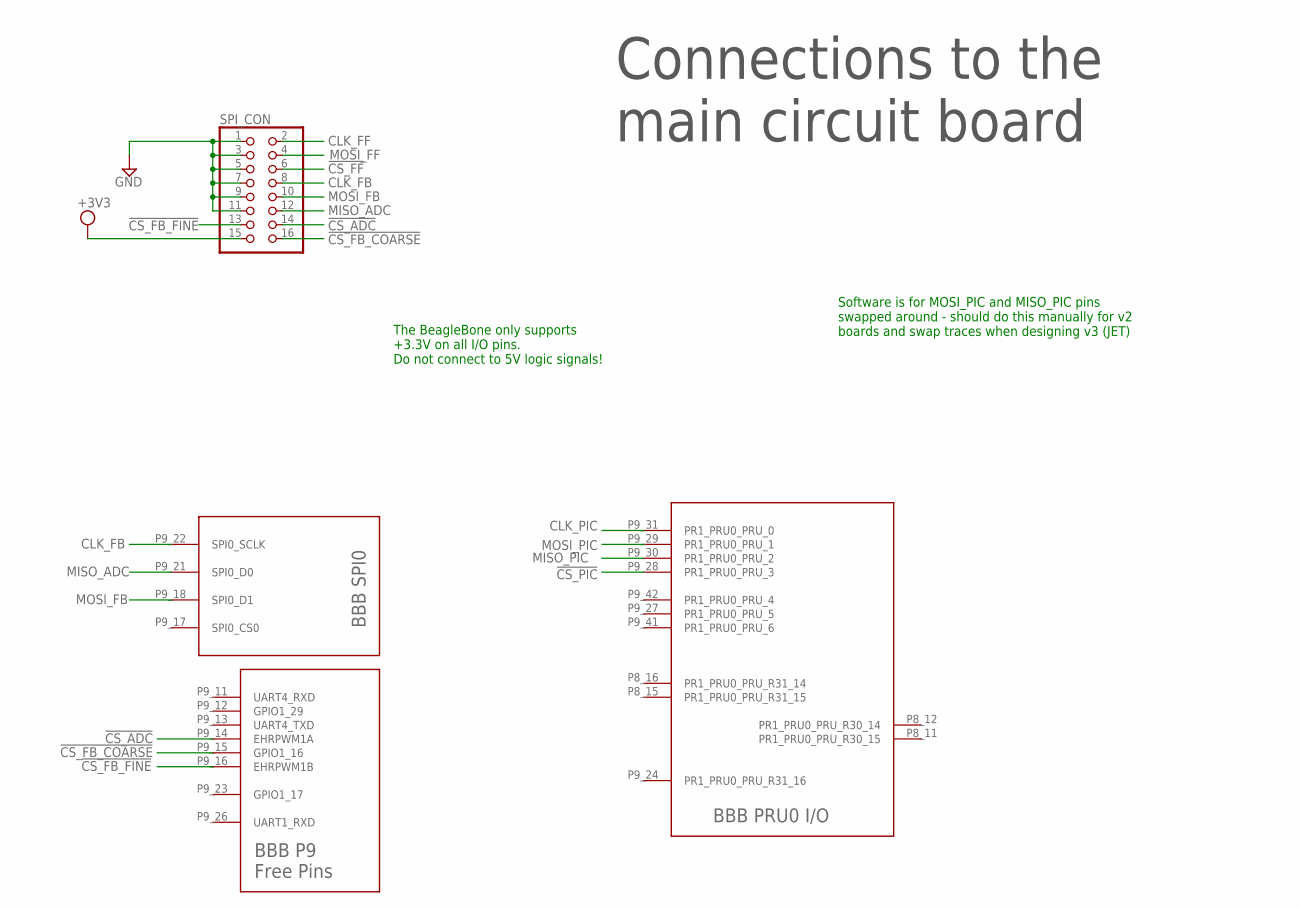
[picture p18: schematic beaglebone black cape.sch, sheet 1]

Parts:
SPI_CON: HEADER-2X8; HEADER-2X8-BOX
U$1: BEAGLEBONE_BLACK

Connections:
3V3: SPI_CON.15; also elsewhere on the board
!CS_ADC: SPI_CON.14, U$1.P9_14 (EHRPWM1A)
!CS_FB_COARSE: SPI_CON.16, U$1.P9_15 (GPIO1_16)
!CS_FB_FINE: SPI_CON.13, U$1.P9_16 (EHRPWM1B)
!CS_FF: SPI_CON.6; also elsewhere on the board
!CS_PIC: U$1.P9_28 (PR1_PRU0_PRU_3)
AGND: U$1.P9_34 (AGND)
CLK_FB: SPI_CON.8, U$1.P9_22 (SPI0_SCLK)
CLK_FF: SPI_CON.2; also elsewhere on the board
CLK_PIC: U$1.P9_31 (PR1_PRU0_PRU_0); also elsewhere on the board
GND: SPI_CON.1, SPI_CON.3, SPI_CON.5, SPI_CON.7, SPI_CON.9, SPI_CON.11; also elsewhere on the board
MISO_ADC: SPI_CON.12, U$1.P9_21 (SPI0_D0)
MISO_PIC: U$1.P9_30 (PR1_PRU0_PRU_2); also elsewhere on the board
MOSI_FB: SPI_CON.10, U$1.P9_18 (SPI0_D1)
MOSI_FF: SPI_CON.4; also elsewhere on the board
MOSI_PIC: U$1.P9_29 (PR1_PRU0_PRU_1); also elsewhere on the board
PWR_BUT: U$1.P9_9 (PWR_BUT)
SYS_5V: U$1.P9_7 (SYS_5V), U$1.P9_8 (SYS_5V)
SYS_RESETN: U$1.P9_10 (SYS_RESETN)
VADC: U$1.P9_32 (VADC)

Notes on the sheet:
The BeagleBone only supports +3.3V on all I/O pins. Do not connect to 5V logic signals!
Connections to the main circuit board
Software is for MOSI_PIC and MISO_PIC pins swapped around - should do this manually for v2 boards and swap traces when designing v3 (JET)

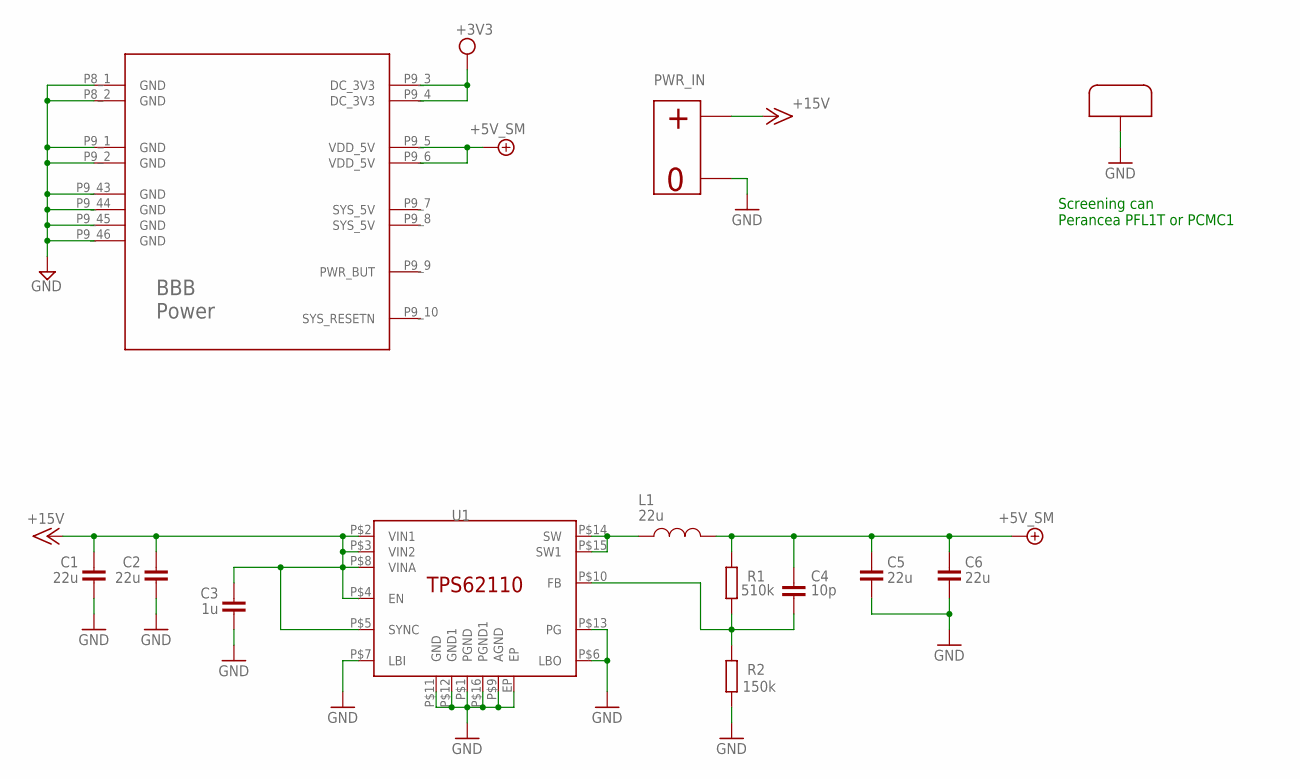
[picture p19: schematic beaglebone black cape.sch, sheet 2]

Parts:
C1, C2, C5, C6: 22u; 0805
C3: 1u; 0805
C4: 10p; 0603
L1: 22u; XAL6060
PWR_IN: MOLEX_POWER_2PIN; MOLEX-2PIN
R1: 510k; 0603
R2: 150k; 0603
U1: TPS62110; QFN16_4
U$1: BEAGLEBONE_BLACK
U$2: SCREENING_CAN; SCREENING_CAN_20X20

Connections:
3V3: U$1.P9_3 (DC_3V3), U$1.P9_4 (DC_3V3); also elsewhere on the board
+5VSM: C4.1, C5.1, C6.1, L1.P$2 (P2), R1.2, U$1.P9_5 (VDD_5V), U$1.P9_6 (VDD_5V)
+15V: C1.1, C2.1, C3.1, PWR_IN.2 (+), U1.P$2 (VIN1), U1.P$3 (VIN2), U1.P$4 (EN), U1.P$5 (SYNC), U1.P$8 (VINA)
AGND: U$1.P9_34 (AGND)
GND: C1.2, C2.2, C3.2, C5.2, C6.2, PWR_IN.1 (GND), R2.1, U1.EP, U1.P$1 (PGND), U1.P$6 (LBO), U1.P$7 (LBI), U1.P$9 (AGND), U1.P$11 (GND), U1.P$12 (GND1), U1.P$13 (PG), U1.P$16 (PGND1), U$1.P8_1 (GND), U$1.P8_2 (GND), U$1.P9_1 (GND), U$1.P9_2 (GND), U$1.P9_43 (GND), U$1.P9_44 (GND), U$1.P9_45 (GND), U$1.P9_46 (GND), U$2.1, U$2.2, U$2.3, U$2.4; also elsewhere on the board
unnamed: L1.P$1 (P1), U1.P$14 (SW), U1.P$15 (SW1)
unnamed: C4.2, R1.1, R2.2, U1.P$10 (FB)
PWR_BUT: U$1.P9_9 (PWR_BUT)
SYS_5V: U$1.P9_7 (SYS_5V), U$1.P9_8 (SYS_5V)
SYS_RESETN: U$1.P9_10 (SYS_RESETN)
VADC: U$1.P9_32 (VADC)

Notes on the sheet:
Screening can Perancea PFL1T or PCMC1

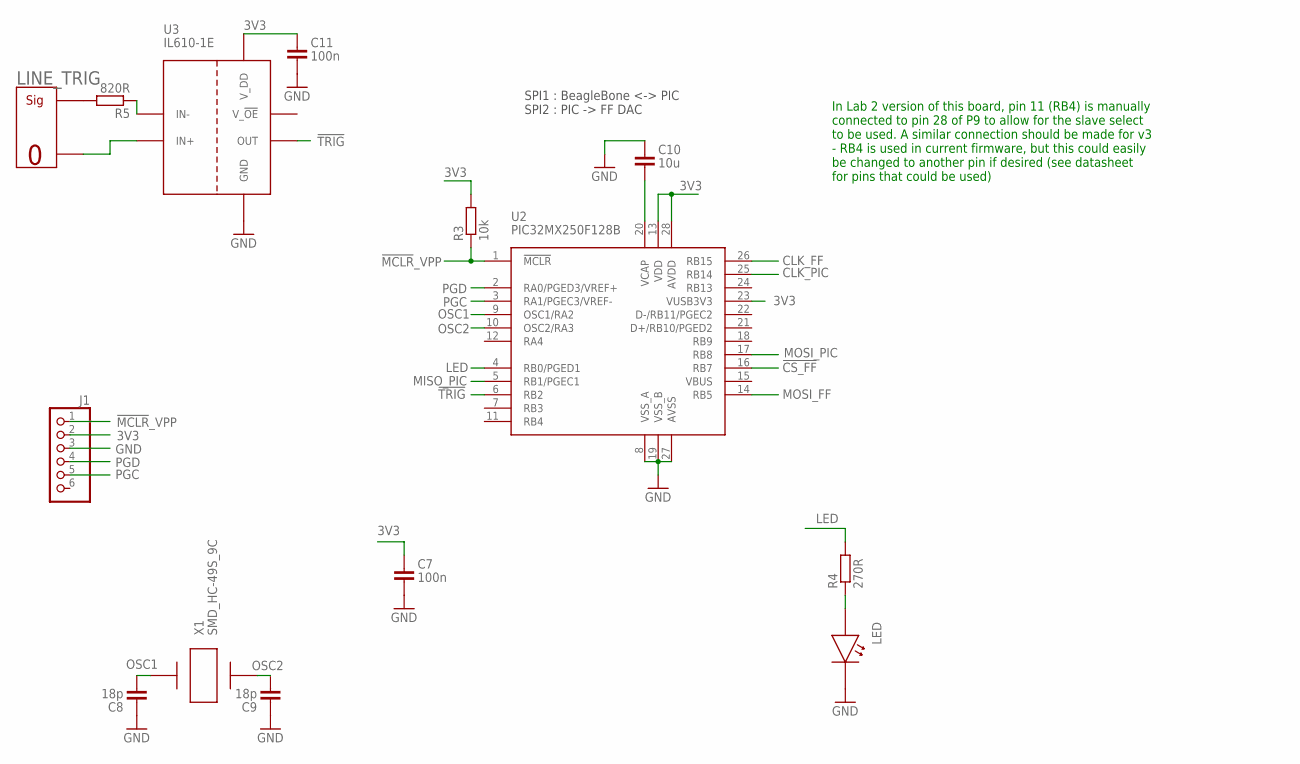
[picture p20: schematic beaglebone black cape.sch, sheet 3]

Parts:
C7, C11: 100n; 0603
C8, C9: 18p; 0603
C10: 10u; 0805
J1: HEADER-1X6; 1X06
LED: OSRAMLED; 0805DIODE
LINE_TRIG: MOLEX_SIG_2PIN; MOLEX-2PIN
R3: 10k; 0603
R4: 270R; 0603
R5: 820R; 0603
U2: PIC32MX250F128B; SSOP28
U3: IL610-1E; MSOP8
X1: SMD_HC-49S_9C

Connections:
3V3: C7.1, C11.1, J1.2, R3.2, U2.13 (VDD), U2.23 (VUSB3V3), U2.28 (AVDD), U3.8 (V_DD); also elsewhere on the board
!CS_FF: U2.16 (RB7); also elsewhere on the board
!MCLR!_VPP: J1.1, R3.1, U2.1 (!MCLR)
!TRIG: U2.6 (RB2), U3.6 (OUT)
CLK_FF: U2.26 (RB15); also elsewhere on the board
CLK_PIC: U2.25 (RB14); also elsewhere on the board
GND: C7.2, C8.1, C9.1, C10.1, C11.2, J1.3, LED.2, LINE_TRIG.1 (GND), U2.8 (VSS_A), U2.19 (VSS_B), U2.27 (AVSS), U3.2 (IN+), U3.5 (GND); also elsewhere on the board
LED: R4.2, U2.4 (RB0/PGED1)
MISO_PIC: U2.5 (RB1/PGEC1); also elsewhere on the board
MOSI_FF: U2.14 (RB5); also elsewhere on the board
MOSI_PIC: U2.17 (RB8); also elsewhere on the board
unnamed: LED.1, R4.1
unnamed: R5.1, U3.3 (IN-)
unnamed: LINE_TRIG.2 (SIG), R5.2
OSC1: C8.2, U2.9 (OSC1/RA2), X1.P$2
OSC2: C9.2, U2.10 (OSC2/RA3), X1.P$1
PGC: J1.5, U2.3 (RA1/PGEC3/VREF-)
PGD: J1.4, U2.2 (RA0/PGED3/VREF+)
VCAP: C10.2, U2.20 (VCAP)

Notes on the sheet:
SPI1 : BeagleBone <-> PIC SPI2 : PIC -> FF DAC
In Lab 2 version of this board, pin 11 (RB4) is manually connected to pin 28 of P9 to allow for the slave select to be used. A similar connection should be made for v3 - RB4 is used in current firmware, but this could easily be changed to another pin if desired (see datasheet for pins that could be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

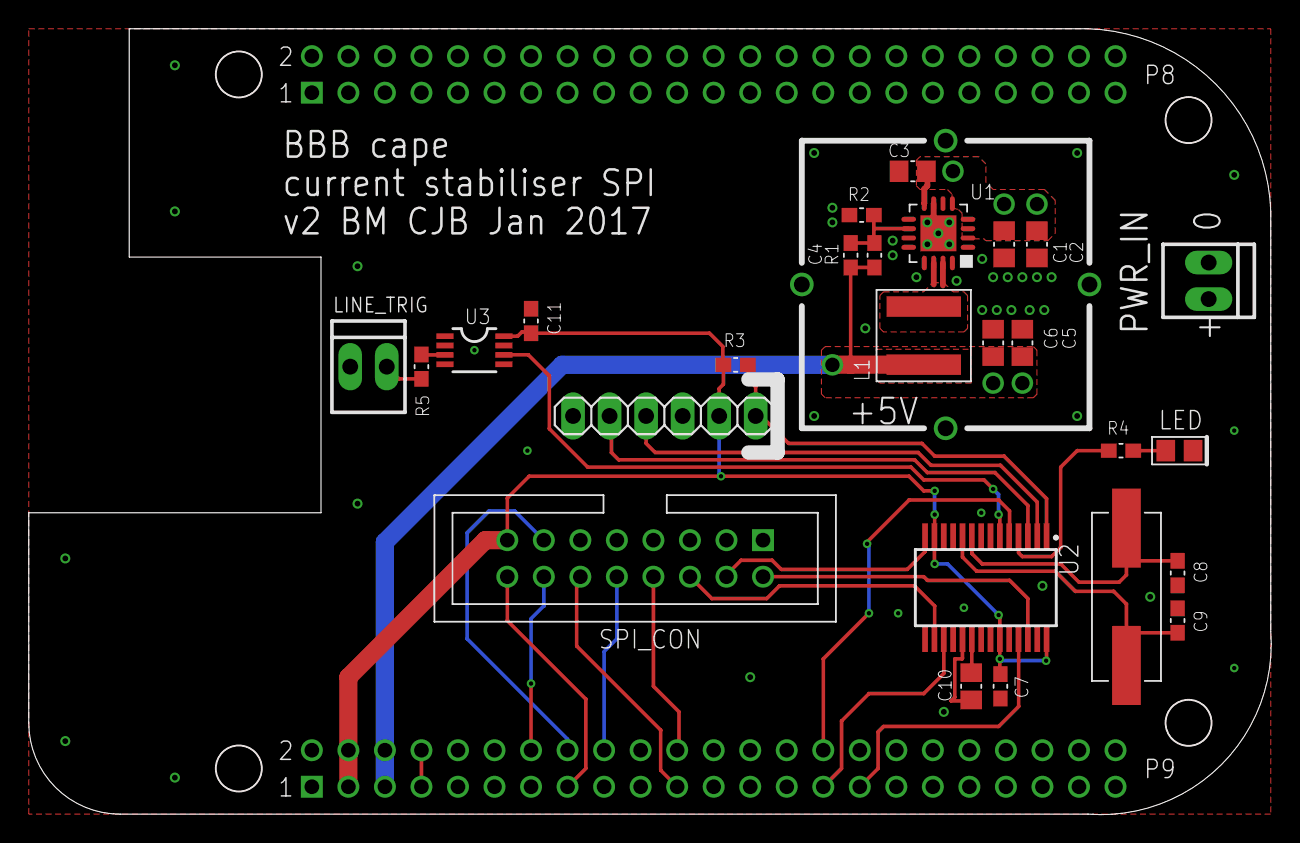
[picture p21: board beaglebone black cape.brd from above]

Board: 2 copper layers, 86.4 x 54.6 mm, 28 parts (0 on the bottom side), 30 nets.
