OxfordIonTrapGroup/CurrentStabilizer/(commit log)

2018-09-12 add beaglebone cape
    [beaglebone black cape.brd, beaglebone black cape.sch]
2018-09-12 add main board
    [current stabiliser.brd, current stabiliser.sch]
2018-09-12 add bom
    [BOM.xlsx]
2018-09-12 add current shunt
    [current shunt.brd, current shunt.sch]
2018-09-12 remove old bom
    [BOM.xlsx]
2019-03-14 update schematics to the version that was used for measurements in https://arxiv.org/abs/1808.03310
    [current shunt.brd, current shunt.sch, current stabiliser.brd, current stabiliser.sch]
